markablov/i4040-sbc/README.md

# i4040-sbc
Single-board computer design for Intel 4040 CPU
