markablov/i4040-sbc/schematic/i4040-sbc.kicad_pcb

## KiCad design schematic/i4040-sbc.kicad_pcb (2023-11-03)

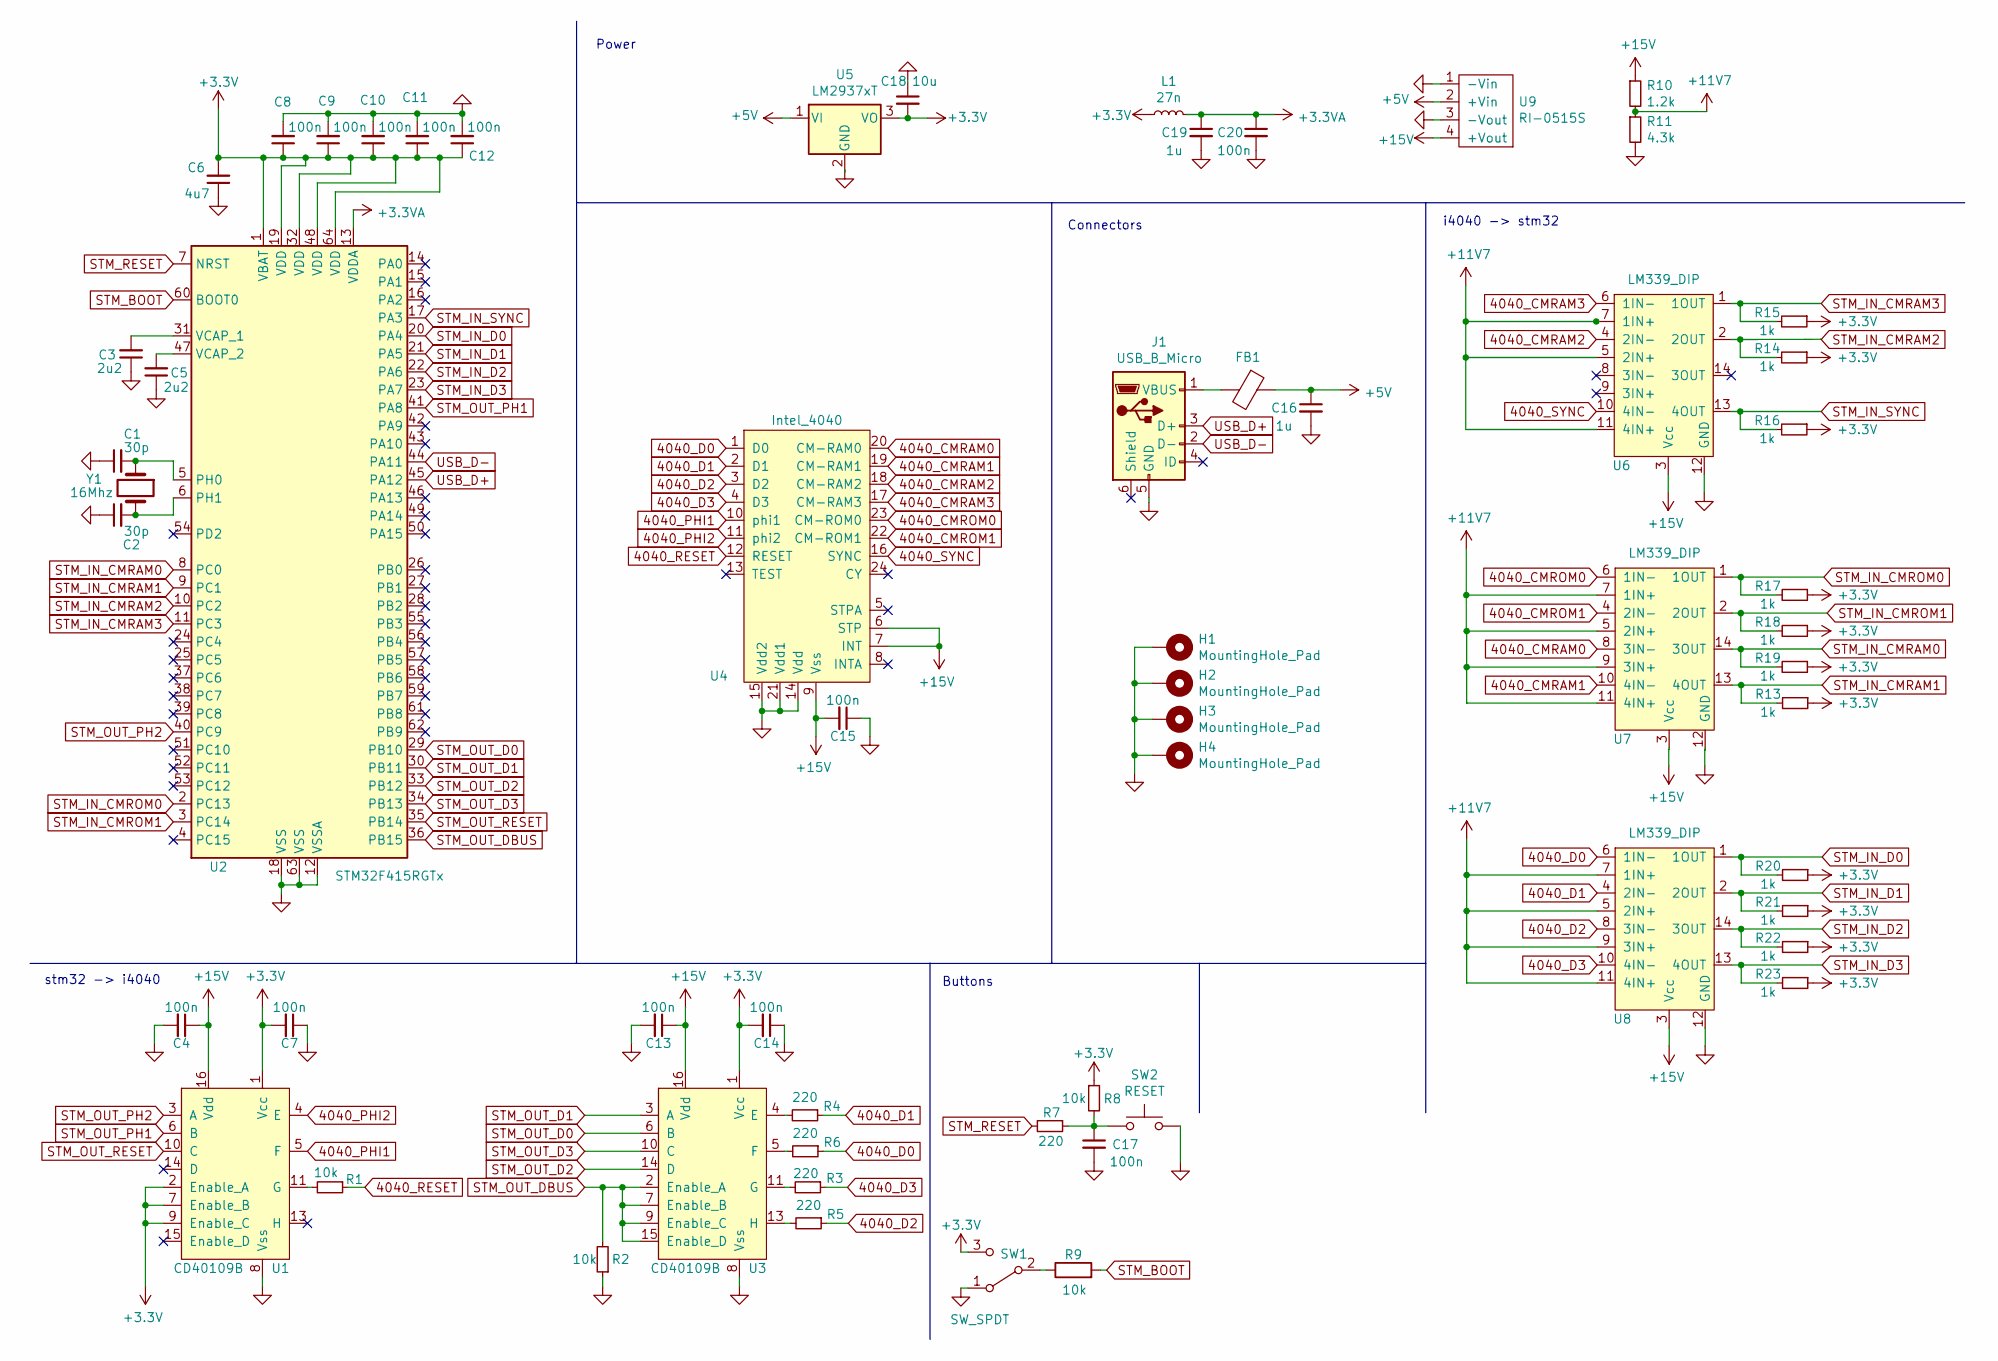
[picture p1: schematic i4040-sbc.kicad_sch, stm32-based memory emulator for MCS4 v2]

Parts:
C1, C2: 30p; C_Pillow_L5.6mm_W4mm_D5.6mm_P5.00mm
C3, C5: 2u2; C_Disc_D4.3mm_W1.9mm_P5.00mm
C4, C7, C13, C14, C15, C17, C20: 100n; C_Disc_D7mm_W5mm_P4.00mm
C6: 4u7; C_Disc_D4.3mm_W1.9mm_P5.00mm
C8, C9, C10, C11, C12: 100n; C_Disc_D4.7mm_W2.5mm_P5.00mm
C16, C19: 1u; C_Disc_D4.3mm_W1.9mm_P5.00mm
C18: 10u; C_Disc_D4.7mm_W2.5mm_P5.00mm
FB1: Ferrite_Bead; L_0402_1005Metric_Pad0.77x0.64mm_HandSolder
H1, H2, H3, H4: MountingHole_Pad; MountingHole_2.2mm_M2_Pad
J1: USB_B_Micro; USB_Micro-B_Amphenol_10104110_Horizontal
L1: 27n; L_0402_1005Metric_Pad0.77x0.64mm_HandSolder
R1, R2, R8, R9: 10k; R_Axial_DIN0207_L6.3mm_D2.5mm_P10.16mm_Horizontal
R3, R4, R5, R6, R7: 220; R_Axial_DIN0207_L6.3mm_D2.5mm_P10.16mm_Horizontal
R10: 1.2k; R_Axial_DIN0207_L6.3mm_D2.5mm_P10.16mm_Horizontal
R11: 4.3k; R_Axial_DIN0207_L6.3mm_D2.5mm_P10.16mm_Horizontal
R13, R14, R15, R16, R19, R20, R21, R22, R23: 1k; R_Axial_DIN0207_L6.3mm_D2.5mm_P10.16mm_Horizontal
R17, R18: 1k; R_Axial_DIN0414_L11.9mm_D4.5mm_P15.24mm_Horizontal
SW1: SW_SPDT; SW_Slide_1P2T_CK_OS102011MS2Q
SW2: RESET; SW_Tact_TS3601
U1, U3: CD40109B; SO-16_5.3x10.2mm_P1.27mm
U2: STM32F415RGTx; LQFP-64_10x10mm_P0.5mm
U4: Intel_4040; DIP-24_W15.24mm_Socket
U5: LM2937xT; TO-220-3_Vertical
U6, U7, U8: LM339_DIP; DIP-14_W7.62mm_Socket
U9: RI-0515S; Converter_DCDC_RECOM_R-78S-0.1_THT
Y1: 16Mhz; Crystal_HC49-U_Vertical

Connections:
4040_CMRAM0: U4.20 (CM-RAM0), U7.8 (3IN-)
4040_CMRAM1: U4.19 (CM-RAM1), U7.10 (4IN-)
4040_CMRAM2: U4.18 (CM-RAM2), U6.4 (2IN-)
4040_CMRAM3: U4.17 (CM-RAM3), U6.6 (1IN-)
4040_CMROM0: U4.23 (CM-ROM0), U7.6 (1IN-)
4040_CMROM1: U4.22 (CM-ROM1), U7.4 (2IN-)
4040_D0: R6.1, U4.1 (D0), U8.6 (1IN-)
4040_D1: R4.1, U4.2 (D1), U8.4 (2IN-)
4040_D2: R5.1, U4.3 (D2), U8.8 (3IN-)
4040_D3: R3.1, U4.4 (D3), U8.10 (4IN-)
4040_PHI1: U1.5 (F), U4.10 (phi1)
4040_PHI2: U1.4 (E), U4.11 (phi2)
4040_RESET: R1.1, U4.12 (RESET)
4040_SYNC: U4.16 (SYNC), U6.10 (4IN-)
+3.3VA: C19.1, C20.1, L1.2, U2.13 (VDDA)
+3V3: C6.2, C7.2, C8.1, C9.1, C10.1, C11.1, C12.1, C14.2, C18.2, L1.1, R8.1, R13.1, R14.1, R15.1, R16.1, R17.1, R18.1, R19.1, R20.1, R21.1, R22.1, R23.1, SW1.3 (C), U1.1 (Vcc), U1.2 (Enable_A), U1.7 (Enable_B), U1.9 (Enable_C), U2.1 (VBAT), U2.19 (VDD), U2.32 (VDD), U2.48 (VDD), U2.64 (VDD), U3.1 (Vcc), U5.3 (VO)
+5V: C16.1, FB1.1, U5.1 (VI), U9.2 (+Vin)
+11V7: R10.2, R11.1, U6.5 (2IN+), U6.7 (1IN+), U6.11 (4IN+), U7.5 (2IN+), U7.7 (1IN+), U7.9 (3IN+), U7.11 (4IN+), U8.5 (2IN+), U8.7 (1IN+), U8.9 (3IN+), U8.11 (4IN+)
+15V: C4.1, C13.1, C15.2, R10.1, U1.16 (Vdd), U3.16 (Vdd), U4.6 (STP), U4.7 (INT), U4.9 (Vss), U6.3 (Vcc), U7.3 (Vcc), U8.3 (Vcc), U9.4 (+Vout)
GND: C1.1, C2.1, C3.1, C4.2, C5.1, C6.1, C7.1, C8.2, C9.2, C10.2, C11.2, C12.2, C13.2, C14.1, C15.1, C16.2, C17.2, C18.1, C19.2, C20.2, H1.1, H2.1, H3.1, H4.1, J1.5 (GND), R2.1, R11.2, SW1.1 (A), SW2.2, U1.8 (Vss), U2.12 (VSSA), U2.18 (VSS), U2.63 (VSS), U3.8 (Vss), U4.14 (Vdd), U4.15 (Vdd2), U4.21 (Vdd1), U5.2 (GND), U6.12 (GND), U7.12 (GND), U8.12 (GND), U9.1 (-Vin), U9.3 (-Vout)
unnamed: C17.1, R7.1, R8.2, SW2.1
unnamed: FB1.2, J1.1 (VBUS)
unnamed: R9.1, SW1.2 (B)
unnamed: R1.2, U1.11 (G)
unnamed: C1.2, U2.5 (PH0), Y1.1
unnamed: C2.2, U2.6 (PH1), Y1.2
unnamed: C3.2, U2.31 (VCAP_1)
unnamed: C5.2, U2.47 (VCAP_2)
unnamed: R4.2, U3.4 (E)
unnamed: R6.2, U3.5 (F)
unnamed: R3.2, U3.11 (G)
unnamed: R5.2, U3.13 (H)
STM_BOOT: R9.2, U2.60 (BOOT0)
STM_IN_CMRAM0: R19.2, U2.8 (PC0), U7.14 (3OUT)
STM_IN_CMRAM1: R13.2, U2.9 (PC1), U7.13 (4OUT)
STM_IN_CMRAM2: R14.2, U2.10 (PC2), U6.2 (2OUT)
STM_IN_CMRAM3: R15.2, U2.11 (PC3), U6.1 (1OUT)
STM_IN_CMROM0: R17.2, U2.2 (PC13), U7.1 (1OUT)
STM_IN_CMROM1: R18.2, U2.3 (PC14), U7.2 (2OUT)
STM_IN_D0: R20.2, U2.20 (PA4), U8.1 (1OUT)
STM_IN_D1: R21.2, U2.21 (PA5), U8.2 (2OUT)
STM_IN_D2: R22.2, U2.22 (PA6), U8.14 (3OUT)
STM_IN_D3: R23.2, U2.23 (PA7), U8.13 (4OUT)
STM_IN_SYNC: R16.2, U2.17 (PA3), U6.13 (4OUT)
STM_OUT_D0: U2.29 (PB10), U3.6 (B)
STM_OUT_D1: U2.30 (PB11), U3.3 (A)
STM_OUT_D2: U2.33 (PB12), U3.14 (D)
STM_OUT_D3: U2.34 (PB13), U3.10 (C)
STM_OUT_DBUS: R2.2, U2.36 (PB15), U3.2 (Enable_A), U3.7 (Enable_B), U3.9 (Enable_C), U3.15 (Enable_D)
STM_OUT_PH1: U1.6 (B), U2.41 (PA8)
STM_OUT_PH2: U1.3 (A), U2.40 (PC9)
STM_OUT_RESET: U1.10 (C), U2.35 (PB14)
STM_RESET: R7.2, U2.7 (NRST)
USB_D+: J1.3 (D+), U2.45 (PA12)
USB_D-: J1.2 (D-), U2.44 (PA11)

Notes on the sheet:
Buttons
Connectors
stm32 -> i4040
Power
i4040 -> stm32

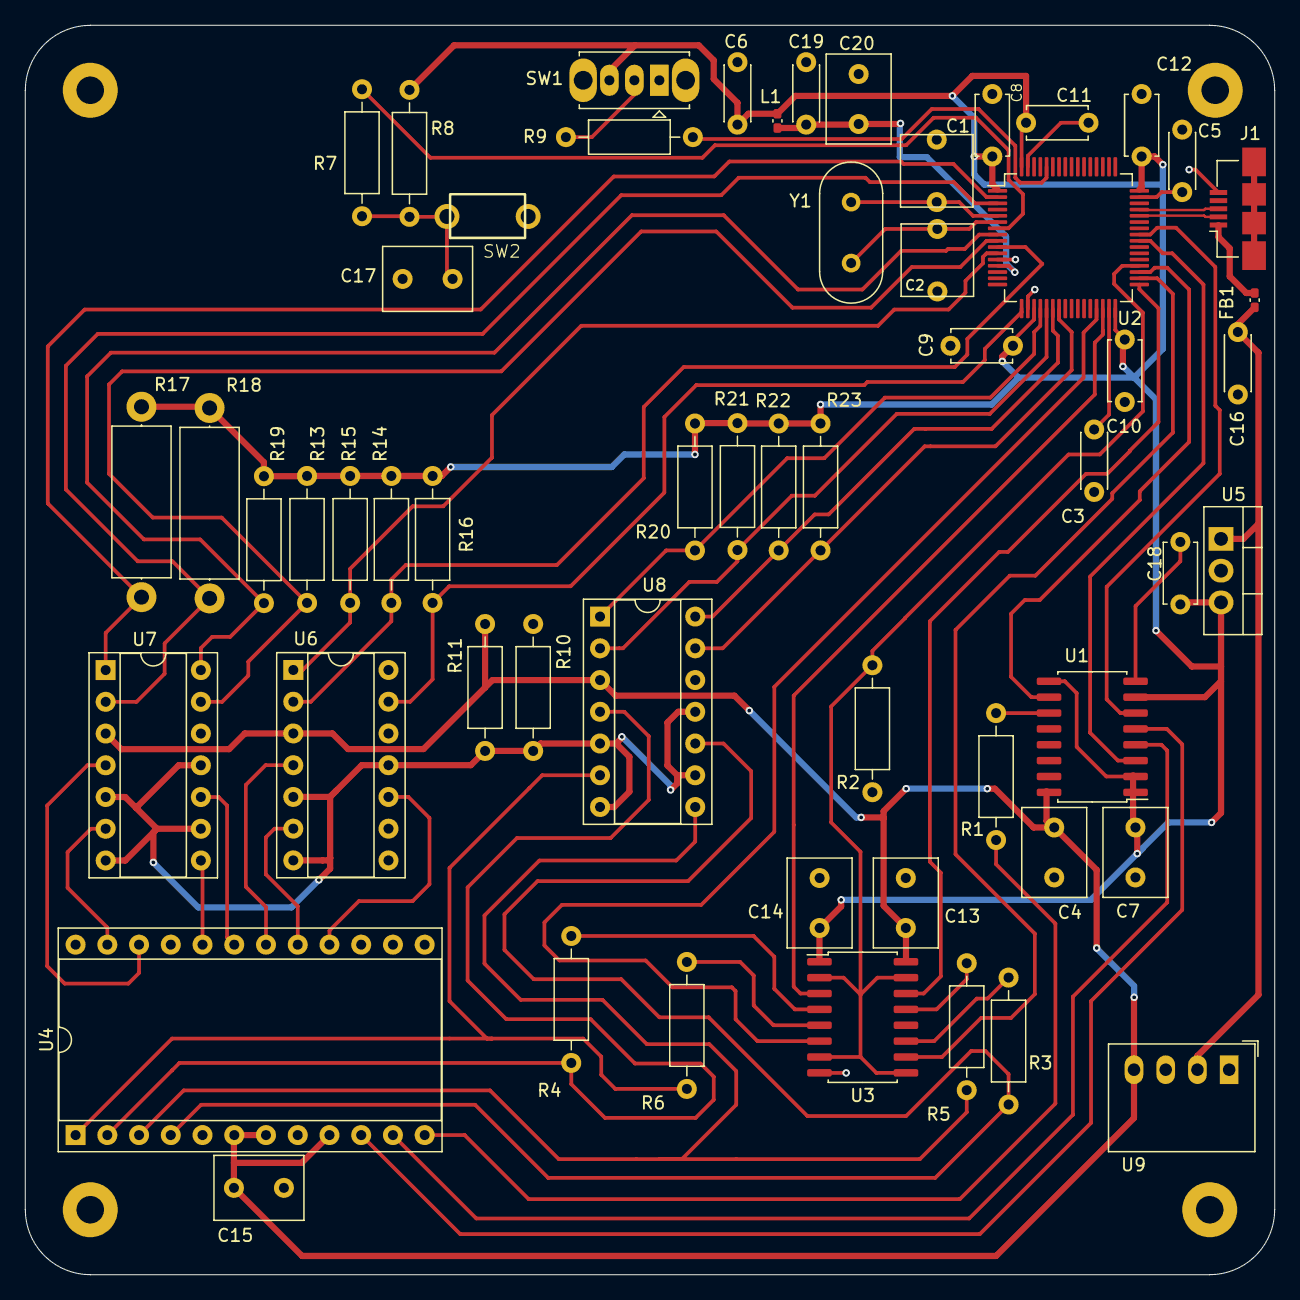
[picture p2: board i4040-sbc.kicad_pcb from above]

Board: 2 copper layers, 100.0 x 100.0 mm, 61 parts (0 on the bottom side), 55 nets.
