markablov/i4040-sbc/firmware/Src/main.c

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
/* Includes ------------------------------------------------------------------*/
#include "main.h"
#include "tim.h"
#include "usb_device.h"
#include "gpio.h"

/* USER CODE BEGIN Includes */
#include "loop.h"
#include "init.h"
/* USER CODE END Includes */


void SystemClock_Config(void);
/**
  * @brief  The application entry point.
  * @retval int
  */
int main(void)
{
  /* USER CODE BEGIN 1 */
  // Boot-loader can set PLL as system clock source, but we need to configure PLL coefs, so temporary switches to HSI
  if (__HAL_RCC_GET_SYSCLK_SOURCE() == RCC_CFGR_SWS_PLL) {
    RCC->CFGR = (RCC->CFGR & ~(RCC_CFGR_SW)) | RCC_CFGR_SW_HSI;
  }
  /* USER CODE END 1 */

  /* MCU Configuration--------------------------------------------------------*/

  /* Reset of all peripherals, Initializes the Flash interface and the Systick. */
  HAL_Init();

  /* Configure the system clock */
  SystemClock_Config();

  /* Initialize all configured peripherals */
  MX_GPIO_Init();
  MX_TIM1_Init();
  MX_TIM8_Init();
  MX_USB_DEVICE_Init();
  /* USER CODE BEGIN 2 */
  init();
  /* USER CODE END 2 */

  /* Infinite loop */
  /* USER CODE BEGIN WHILE */
  while (1)
  {
    /* USER CODE END WHILE */

    /* USER CODE BEGIN 3 */
    loopTick();
  }
  /* USER CODE END 3 */
}

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
