markablov/i4040-sbc/firmware/Inc/main.h

#define IN_4040_CMROM0_Pin GPIO_PIN_13
#define IN_4040_CMROM0_GPIO_Port GPIOC
#define IN_4040_CMROM1_Pin GPIO_PIN_14
#define IN_4040_CMROM1_GPIO_Port GPIOC
#define IN_4040_CMRAM0_Pin GPIO_PIN_0
#define IN_4040_CMRAM0_GPIO_Port GPIOC
#define IN_4040_CMRAM1_Pin GPIO_PIN_1
#define IN_4040_CMRAM1_GPIO_Port GPIOC
#define IN_4040_CMRAM2_Pin GPIO_PIN_2
#define IN_4040_CMRAM2_GPIO_Port GPIOC
#define IN_4040_CMRAM3_Pin GPIO_PIN_3
#define IN_4040_CMRAM3_GPIO_Port GPIOC
#define OUT_LED_Pin GPIO_PIN_0
#define OUT_LED_GPIO_Port GPIOA
#define IN_4040_SYNC_Pin GPIO_PIN_3
#define IN_4040_SYNC_GPIO_Port GPIOA
#define IN_4040_D0_Pin GPIO_PIN_4
#define IN_4040_D0_GPIO_Port GPIOA
#define IN_4040_D1_Pin GPIO_PIN_5
#define IN_4040_D1_GPIO_Port GPIOA
#define IN_4040_D2_Pin GPIO_PIN_6
#define IN_4040_D2_GPIO_Port GPIOA
#define IN_4040_D3_Pin GPIO_PIN_7
#define IN_4040_D3_GPIO_Port GPIOA
#define OUT_TEST0_Pin GPIO_PIN_5
#define OUT_TEST0_GPIO_Port GPIOC
#define OUT_TEST1_Pin GPIO_PIN_1
#define OUT_TEST1_GPIO_Port GPIOB
#define OUT_4040_D0_Pin GPIO_PIN_10
#define OUT_4040_D0_GPIO_Port GPIOB
#define OUT_4040_D1_Pin GPIO_PIN_11
#define OUT_4040_D1_GPIO_Port GPIOB
#define OUT_4040_D2_Pin GPIO_PIN_12
#define OUT_4040_D2_GPIO_Port GPIOB
#define OUT_4040_D3_Pin GPIO_PIN_13
#define OUT_4040_D3_GPIO_Port GPIOB
#define OUT_4040_RESET_Pin GPIO_PIN_14
#define OUT_4040_RESET_GPIO_Port GPIOB
#define OUT_4040_DBUS_Pin GPIO_PIN_15
#define OUT_4040_DBUS_GPIO_Port GPIOB
#define OUT_4040_PHI2_Pin GPIO_PIN_9
#define OUT_4040_PHI2_GPIO_Port GPIOC
#define OUT_4040_PHI1_Pin GPIO_PIN_8
#define OUT_4040_PHI1_GPIO_Port GPIOA
