markablov/i4040-sbc/(notices)

Notices in the files:
firmware/Inc/main.h:
© Copyright (c) 2020 STMicroelectronics.
All rights reserved.
This software component is licensed by ST under Ultimate Liberty license
